delboy711/ArduinoOpenTherm/photos/IMG_20140204_115322.jpg

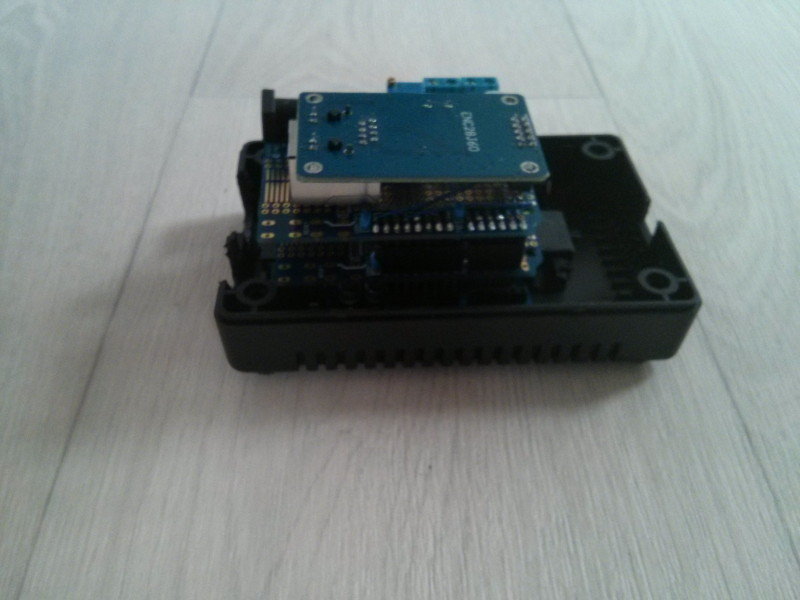
photos/IMG_20140204_115322.jpg
