delboy711/ArduinoOpenTherm/photos/IMG_20140204_115043.jpg

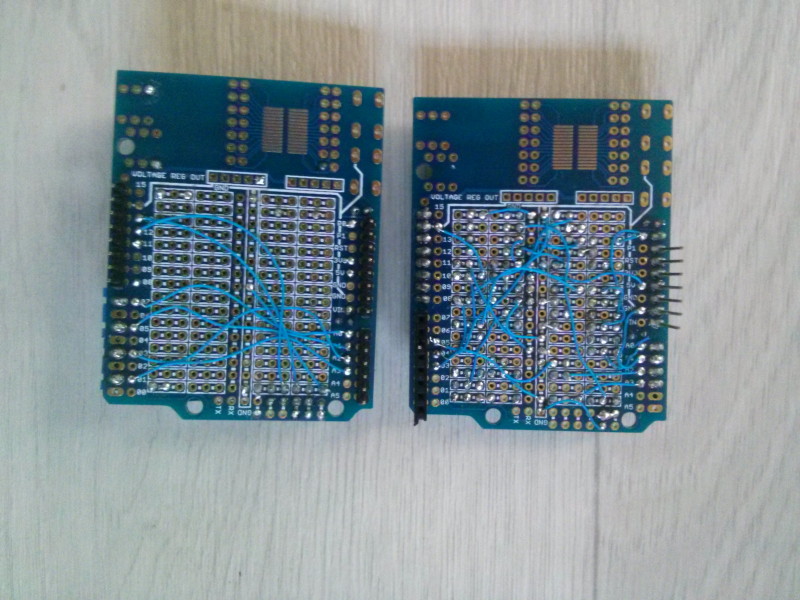
photos/IMG_20140204_115043.jpg
