delboy711/ArduinoOpenTherm/opentherm_gateway_schematic.png

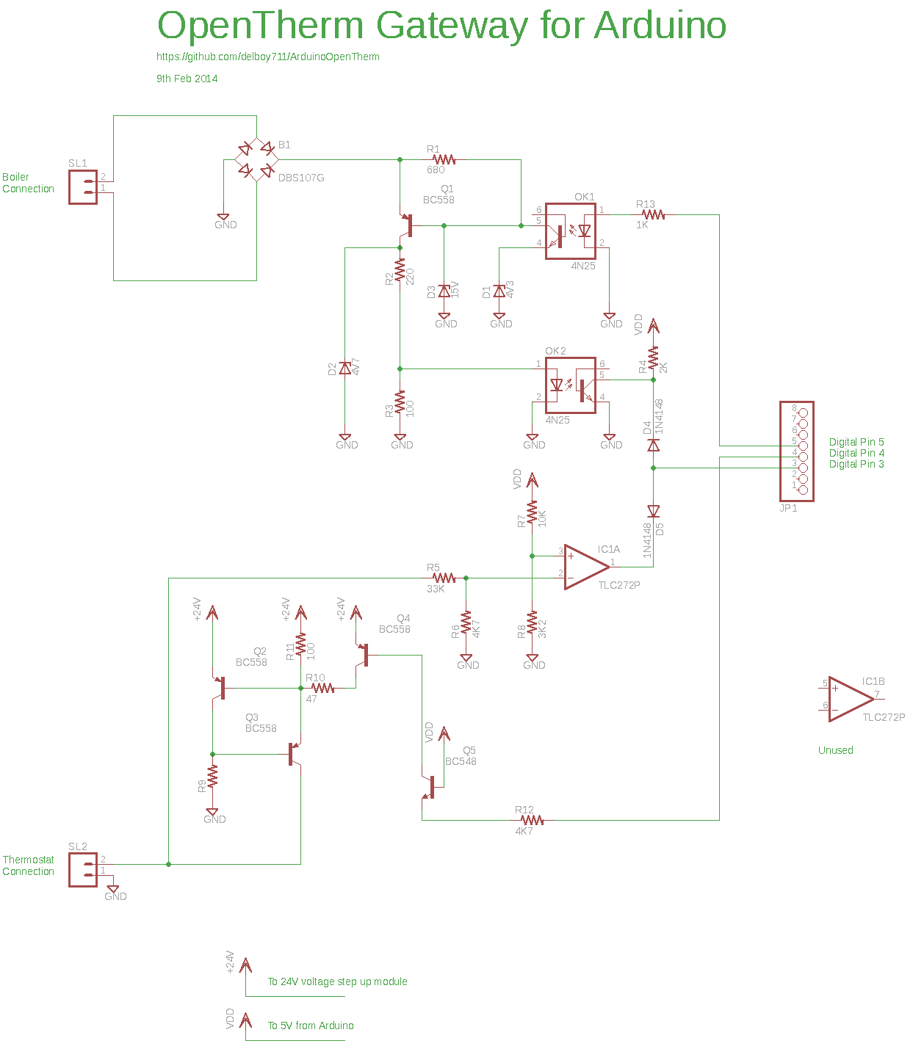
opentherm_gateway_schematic.png
