delboy711/ArduinoOpenTherm/photos/IMG_20140204_114637.jpg

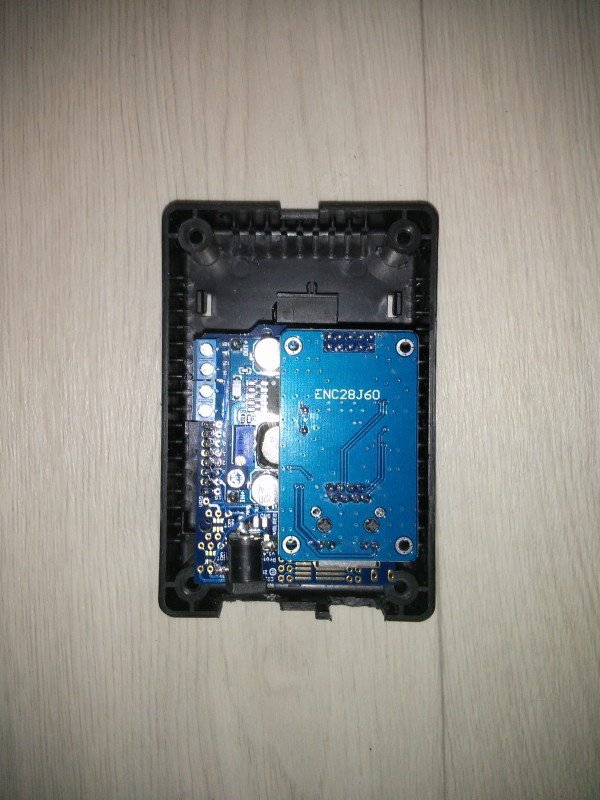
photos/IMG_20140204_114637.jpg
