delboy711/ArduinoOpenTherm/photos/IMG_20140204_114720.jpg

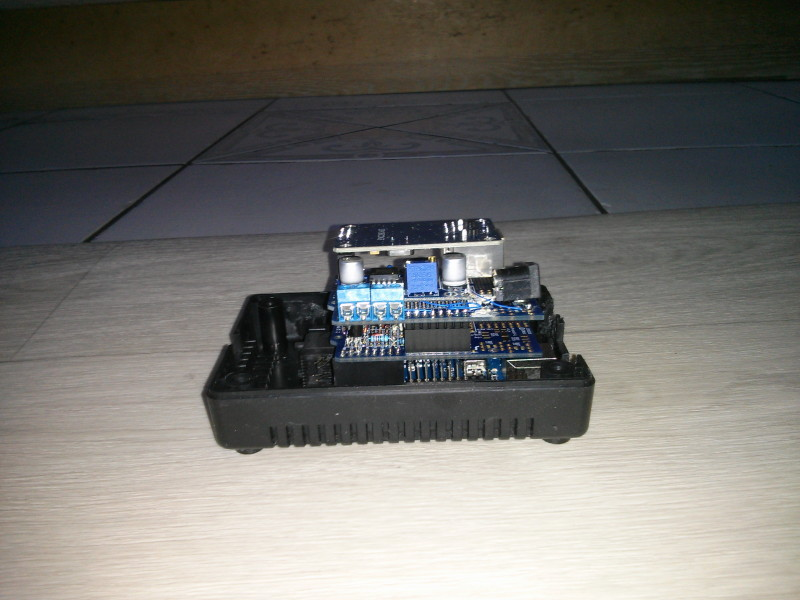
photos/IMG_20140204_114720.jpg
