delboy711/ArduinoOpenTherm/photos/IMG_20140204_114903.jpg

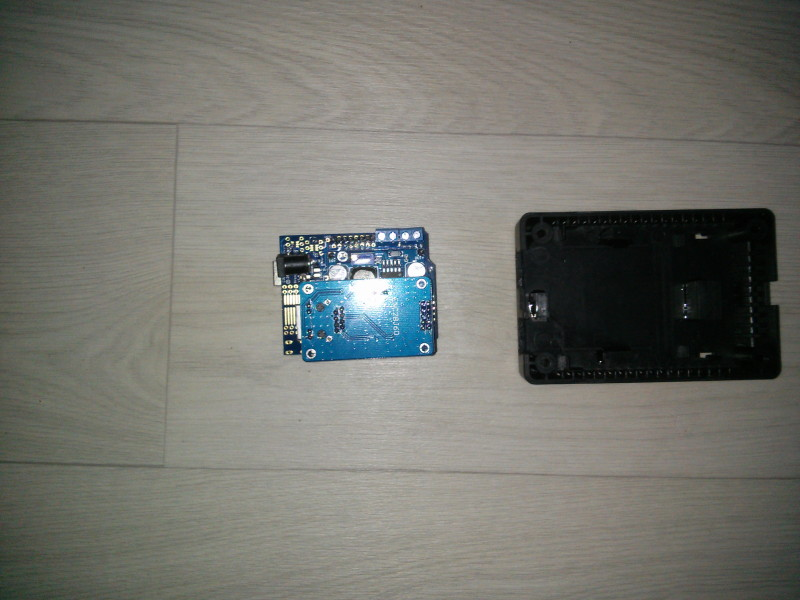
photos/IMG_20140204_114903.jpg
