delboy711/ArduinoOpenTherm/photos/IMG_20140204_115003.jpg

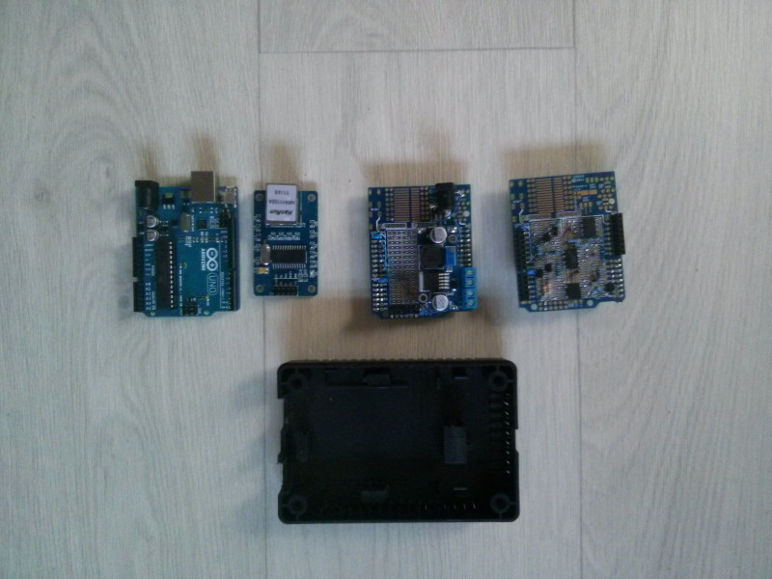
photos/IMG_20140204_115003.jpg
