delboy711/ArduinoOpenTherm/photos/IMG_20140204_115018.jpg

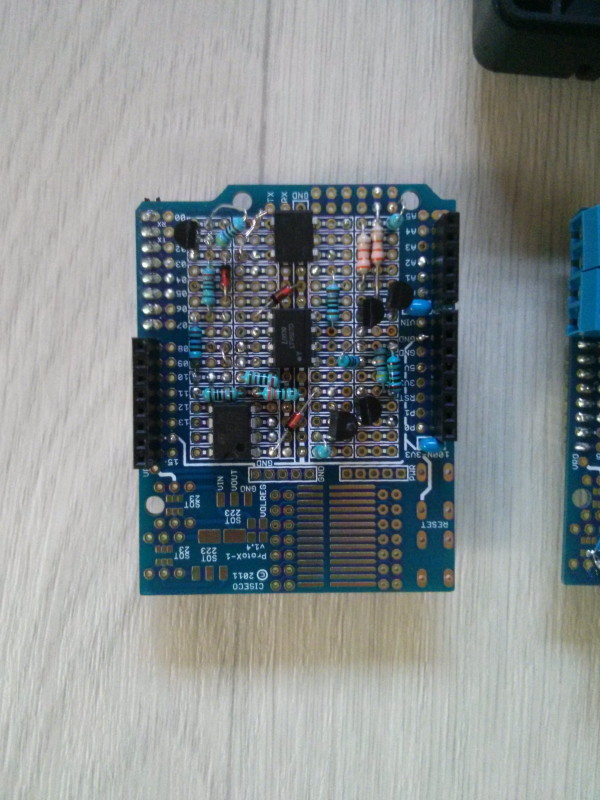
photos/IMG_20140204_115018.jpg
