delboy711/ArduinoOpenTherm/photos/IMG_20140204_115030.jpg

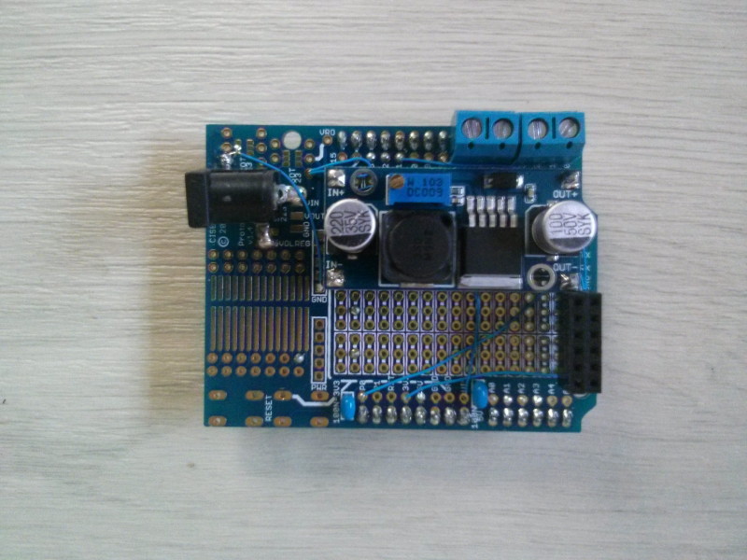
photos/IMG_20140204_115030.jpg
