delboy711/ArduinoOpenTherm/photos/IMG_20140204_115056.jpg

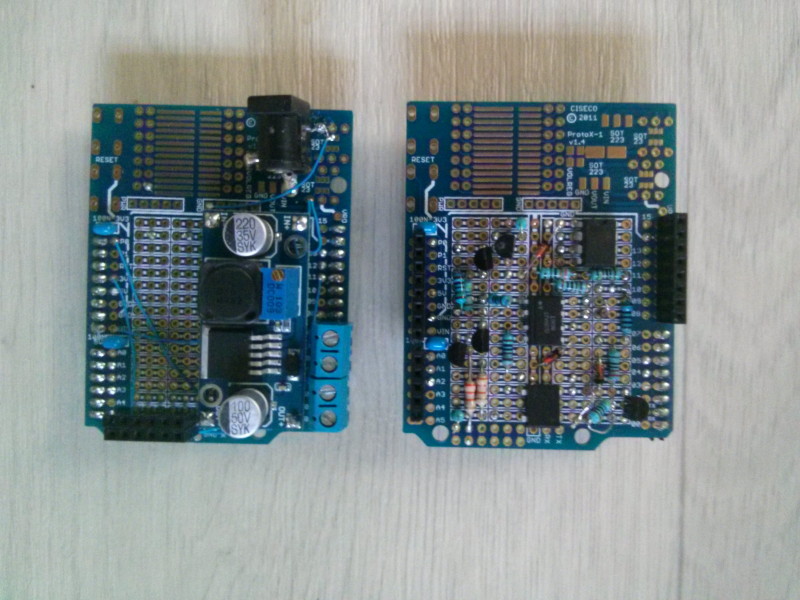
photos/IMG_20140204_115056.jpg
