delboy711/ArduinoOpenTherm/photos/IMG_20140204_115156.jpg

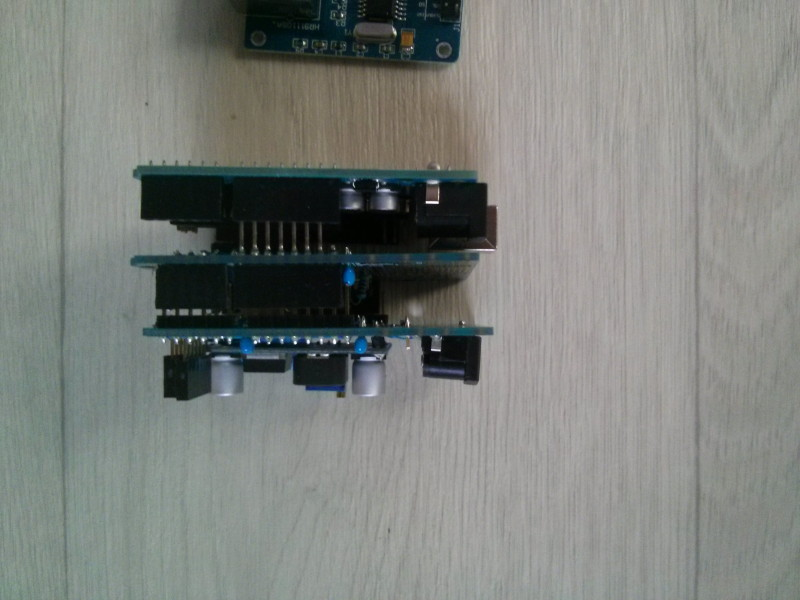
photos/IMG_20140204_115156.jpg
