delboy711/ArduinoOpenTherm/photos/IMG_20140204_115219.jpg

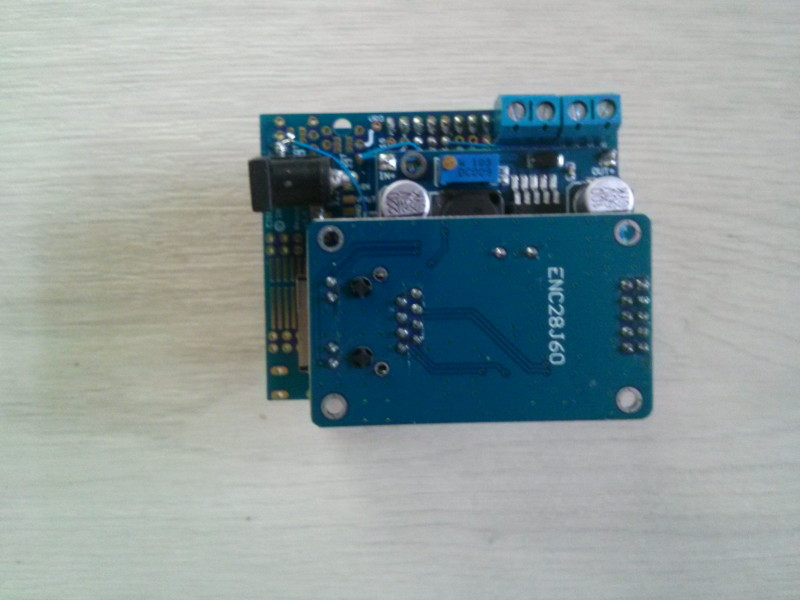
photos/IMG_20140204_115219.jpg
