delboy711/ArduinoOpenTherm/photos/IMG_20140204_115229.jpg

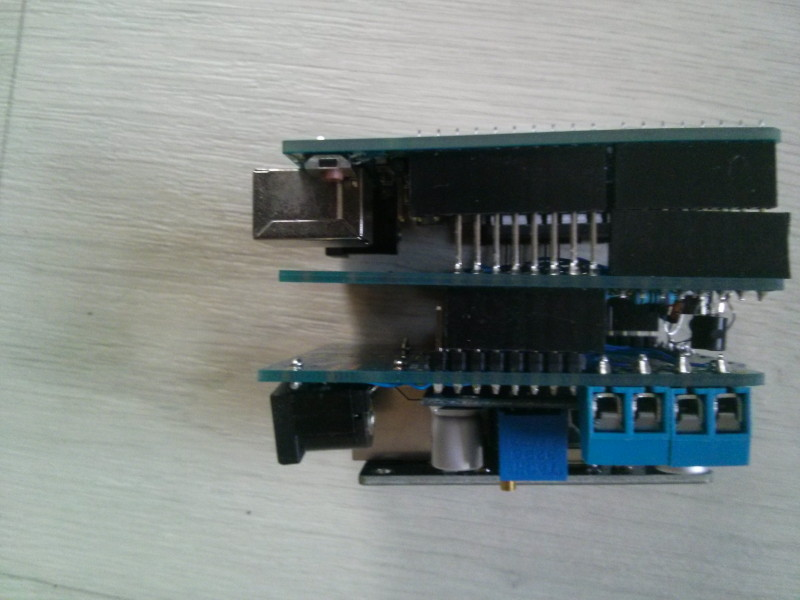
photos/IMG_20140204_115229.jpg
