delboy711/ArduinoOpenTherm/photos/IMG_20140204_115335.jpg

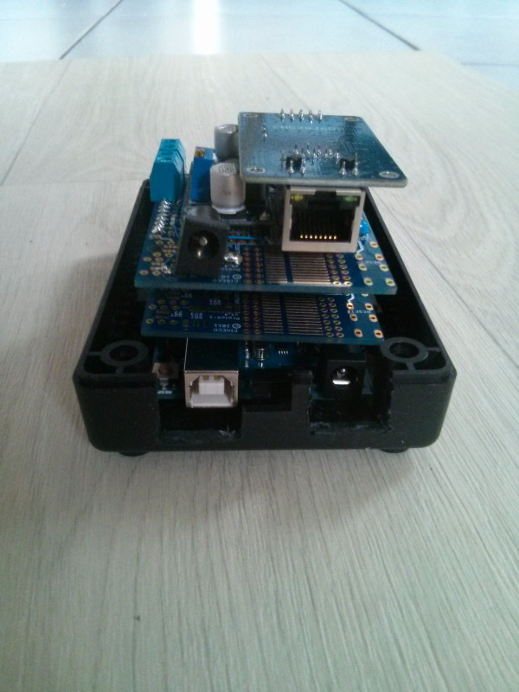
photos/IMG_20140204_115335.jpg
