delboy711/ArduinoOpenTherm/photos/IMG_20140204_115348.jpg

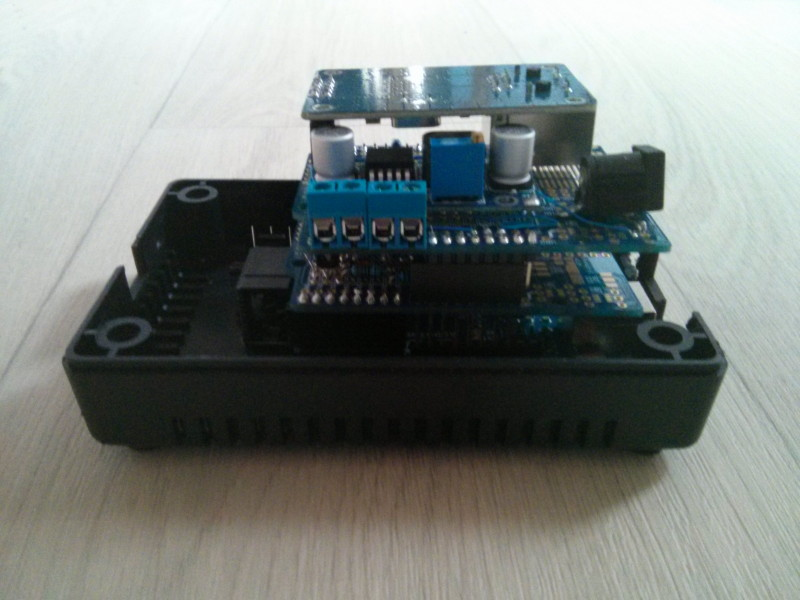
photos/IMG_20140204_115348.jpg
