delboy711/ArduinoOpenTherm/photos/IMG_20140204_115359.jpg

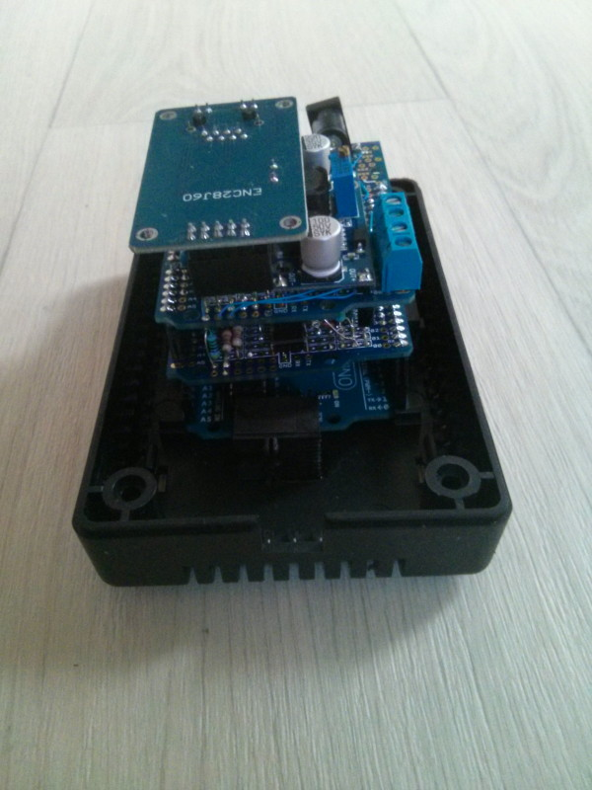
photos/IMG_20140204_115359.jpg
