delboy711/ArduinoOpenTherm/(commit log)

2014-02-01 Fix parity calculation Add constant temp algorithm Tidy up code
    [OT_encoder_decoder.ino]
2014-02-05 Move xively account details to a separerate file Add new 'distance' strategy Add code to reset Ethernet module if it hangs
    [OT_encoder_decoder.ino]
2014-02-09 Fixed issue with Trmaha control locking up when setting Timme/Date Added schematic of gateway
2014-02-10 * Fix issue with Remaha control locking up when updating time/date * cleanups
    [OT_encoder_decoder.ino]
